RevWeaver/CamCap/housing/body.stl

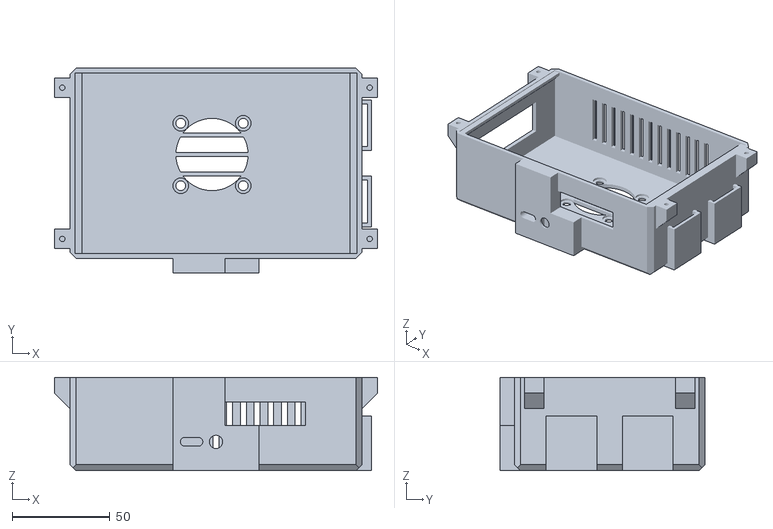
[picture p1: CAD file, 2026-10-09]
housing/body.stl
165.4 x 104.8 x 47.7
