RevWeaver/CamCap/housing/fan_mount_test.stl

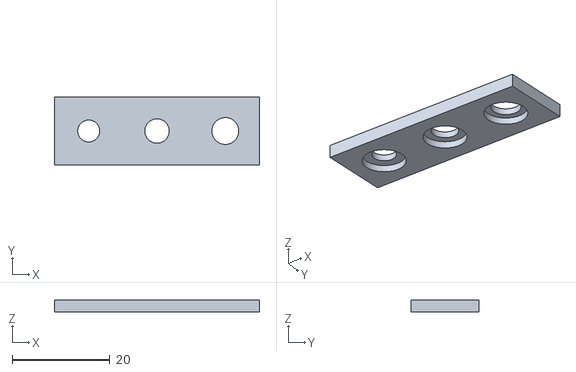
[picture p2: CAD file, 2026-10-09]
housing/fan_mount_test.stl
42.0 x 14.0 x 2.50
