RevWeaver/CamCap/housing/bezel.stl

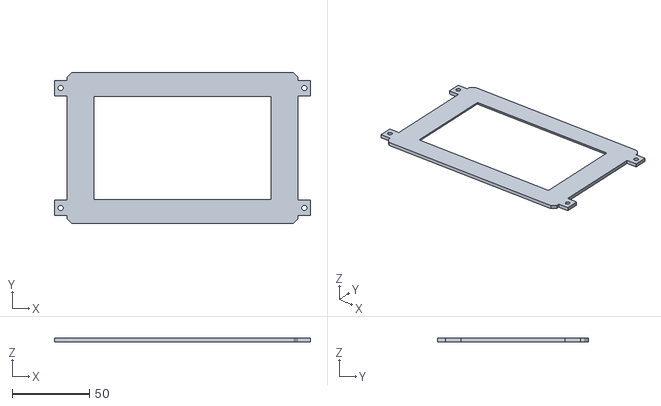
[picture p3: CAD file, 2026-10-09]
housing/bezel.stl
165.4 x 97.5 x 2.50
