RevWeaver/CamCap/(commit log)

2026-07-22 Add clean camera status display
2026-07-22 Expand camera configuration settings
2026-09-15 Replace storage.py with DriveManager, fix recording reliability bugs
    Rewrites the fixed-CAMCAP-label storage module as DriveManager, which
    detects and mounts arbitrary USB drives, sets up the CamCap directory
    layout, and checks writability against the actual mount state instead
    of just probing a path that can silently exist on the SD card after
    the SSD disconnects.
    Also fixes several bugs found while testing against the real camera
    and SSD:
    - storage_is_writable() reported writable even when the SSD wasn't
    mounted, because it only tried writing a file rather than checking
    is_mounted() first
    - Recorder.start() blocked all future recordings after any failed or
    dead ffmpeg process, since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
2026-09-15 Survive and recover from USB drive disconnect/reconnect
    Tested against a real unplug/replug of the recording SSD mid-session.
    Found and fixed two real bugs plus added the recovery path that was
    still missing:
    - Recorder.stop() crashed the whole app with an uncaught OSError when
    os.rename() failed because storage disappeared mid-write. A storage
    loss during stop now just gets logged instead of taking the process
    down.
    - DriveManager.mount_drive() trusted os.path.ismount() alone, but
    Linux doesn't clear the mount table when a drive is physically
    yanked - the mountpoint kept reporting "mounted" against a dead
    entry, so a reconnected drive was never remounted. mount_drive() now
    ch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
2026-09-16 Verify drive is actually writable before reporting mount success
    mount_drive() previously reported success whenever the mount command
    succeeded, even if the app couldn't write to the drive afterward -
    freshly formatted or foreign drives default to root ownership, unlike
    an SD card that just works. Now it verifies writability, auto-fixes
    ownership once if needed, and fails cleanly (unmount + False) if the
    drive still isn't usable.
    initialize() also now catches OSError and fails gracefully instead of
    crashing camcap.py's startup and storage watchdog when a drive can't
    be prepared.
2026-09-16 Add live preview, touch record controls, and recording review/playback
    Builds out ui/main_window.py into a real touchscreen GUI (PyQt5 on
    eglfs, no X11) with three screens: live camera preview + record/stop,
    a list of past recordings, and in-app playback with seek/pause. The
    "one reader at a time" camera handoff (preview <-> recorder) from the
    prior session's investigation is now actually implemented.
    Two reliability bugs found via hardware testing along the way:
    - Recorder.stop()'s multi-second ffmpeg shutdown drain was blocking
    the GUI thread, freezing the touch UI on every STOP press. Moved to
    a background StopWorker thread.
    - PreviewWorker/PlaybackWorker stopped draining ffmpeg's ou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
2026-09-17 Keep ffmpeg.log off the removable drive
    The log was written under CamCap/LOGS on the mounted SSD, so a drive
    disconnect wiped out the exact log you'd want to diagnose that
    disconnect. It now lives locally under CamCap/logs/, next to the app
    code, independent of whatever storage is plugged in.
    Verified with a real recording: log now lands at
    /home/deposit150/CamCap/logs/ffmpeg.log and the drive's LOGS folder is
    no longer touched.
2026-09-17 Fix real thermal throttling during sustained recording with x264 preset
    Hardware-tested a 3-minute sustained 1080p30 recording on the Pi 4B:
    the default libx264 preset ("medium") pushed the Pi into real thermal
    throttling within ~90s (measured up to 85C, throttled=0xe0008), and
    once throttled, ffmpeg's shutdown drain exceeded STOP_TIMEOUT_SECONDS
    and had to be SIGKILLed - which left the recording renamed into the
    final filename without ever getting a matroska trailer, so it reports
    no duration despite the video data itself still being decodable.
    Switching to "-preset veryfast" was tested the same way (same 3-minute
    recording, same starting temp): held steady at 62-70C with no
    throttling at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
2026-09-17 Fix camera detection to actually use the stable by-id device path
    config.CAMERA_DEVICE already held the persistent
    /dev/v4l/by-id/...-video-index0 path from an earlier fix, but nothing
    in the codebase ever read it - both ui/main_window.py and the old
    camcap.py terminal loop call camera.get_camera_device() instead, which
    parsed `v4l2-ctl --list-devices` and returned whatever /dev/videoN
    index the kernel happened to enumerate that boot. That index isn't
    guaranteed stable across reboots or USB resets (the Pi's own bcm2835
    codec nodes and the Cam Link both show up as /dev/videoN), so the
    by-id fix was silently dead code.
    get_camera_device() now resolves the by-id symlink directly and is the
    sin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
2026-09-17 Detect camera disconnect/reconnect while idle, mirroring the storage watchdog
    Storage already has a watchdog that notices a lost/reconnected drive
    and recovers automatically, but nothing did the equivalent for the
    camera - if the Cam Link disconnected while idle or previewing (or hit
    the known UVC URB wedge), the app just froze on the last preview frame
    forever with the status bar still claiming "Cam: OK", and never
    recovered even if the camera came back.
    _watchdog_tick now also polls camera.get_camera_device() each tick:
    on disconnect, stops the preview cleanly and shows "No camera
    detected"; on reconnect, restarts the preview automatically. A
    recording in progress is already handled by th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
2026-09-17 Finalize an active recording on graceful shutdown (SIGTERM/SIGINT)
    main.py had no signal handler, so `systemctl stop camcap`,
    `sudo poweroff`, and `sudo reboot` killed the process outright without
    ever running closeEvent - ffmpeg itself shuts down cleanly on the same
    SIGTERM (from the shared cgroup kill), but the .tmp -> final rename only
    happens in Python, so an in-progress recording was stranded as an
    unfinalized .tmp file forever. Also found the previously-untested idle
    shutdown path was exiting status=1/FAILURE.
    Added a SIGTERM/SIGINT handler (via a QTimer poll, since a Qt app
    blocked in its C++ event loop won't otherwise notice a Python signal in
    time) that triggers window.close(), reu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
2026-09-25 Restart a dead preview when the camera is present
    A fast Cam Link unplug/replug can fall entirely between two watchdog
    ticks, so the disconnect branch never fires - but ffmpeg still exits
    when the device vanishes, leaving a frozen preview while the app thinks
    the camera is fine. Restart the preview whenever its worker has
    finished, rate-limited to once per 5s to avoid hammering the UVC driver.
2026-09-25 Switch recording to the Pi's hardware H.264 encoder
    libx264 can't encode real 1080p30 camera footage in real time on the
    Pi 4: on a detailed scene veryfast managed ~11fps and ultrafast ~24fps
    with all cores pegged. Recordings dropped most frames and wrote nothing
    within the 2s health-check window, so every recording was killed and
    discarded after ~5s.
    h264_v4l2m2m held ~29fps over a 3-minute test with no kernel errors
    (including repeated start/stop cycles), stops cleanly in ~1-3s, and
    writes data well within the health-check window. Set a 2s keyframe
    interval; the encoder's default of 12 frames wastes bitrate.
2026-09-25 Warn on the status bar when the Cam Link is on a USB 2 port
    Uncompressed 1080p30 doesn't fit through USB 2: the preview still limps
    along, but recordings get corrupted/empty frames and fail after the
    health check. Hardware-tested through a USB 2.0 hub. Read the link speed
    from sysfs and show 'SLOW USB PORT' instead of 'OK'.
2026-09-25 Add touchscreen boot fix and track system config files
    - camcap-touch.service re-binds the Goodix touch controller at boot; it
    fails its probe because it's probed before the DSI panel powers up.
    camcap.service now Wants/After it (not Requires, so the app still runs
    if touch fails).
    - Track eglfs_kms.json (pins Qt to the DSI panel, HDMI off) and copies of
    camcap.service and the touch-rotation udev rule under system/, so a
    fresh Pi can be rebuilt from git. README documents where each goes.
2026-09-30 Show the Pi's CPU temperature in the status bar
2026-09-30 Colour the status bar temperature orange at 70C and red at 80C
2026-10-09 Add 3D-printed housing (v0.5.2) with rendered STLs
    OpenSCAD source for the upright field-monitor case plus the body, bezel
    and fan mount test STLs, rendered from it.
    Changes since the first printed version (v0.2):
    - Bottom plate with a captive 1/4"-20 nut (crush ribs hold it in) and an
    anti-twist pin slot, for a ball-head shoe mount; replaces the printed
    cold-shoe foot
    - Power slot 1" longer to the right; the plate corner that would print
    hanging over it is trimmed away
    - Display stops 1mm wider on each side
    - 3mm chamfers on the body's long edges and around the fan wall (left
    square behind the strap loops), with matching bezel corners; screw
    tabs moved 2mm in so each chamfer meet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
2026-10-11 Record audio from the DJI Mic Mini receiver when it's plugged in
    The receiver shows up as a USB ALSA card that only offers 48kHz stereo
    S24_3LE, so ffmpeg's ALSA input needs pcm_s24le given explicitly.
    microphone.py finds it via /dev/snd/by-id (card numbers aren't stable)
    and the recorder adds it as an optional AAC track - no receiver means a
    video-only recording, not a failure. If the receiver drops out
    mid-recording ffmpeg keeps recording video (hardware-tested by
    deauthorizing it over USB); the status bar shows Mic: OK / NONE / LOST.
    A/V start offset measured on a common clock: audio's first sample lands
    ~20ms after video's first frame, consistently over 6 runs - under one
    frame, so ffmp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
2026-10-12 Add an on-screen power menu for shutting down or restarting
    A power-icon button at the far left of the control bar opens a page
    with SHUT DOWN / RESTART / CANCEL, so the appliance can be turned off
    without pulling power on a running Pi. It runs `sudo systemctl
    poweroff|reboot`; systemd's SIGTERM then goes through main.py's
    existing clean-close path. Disabled while recording.
2026-10-12 Tell the user to restart when the hardware encoder has crashed
    After the bcm2835_codec Oops every encoder open hangs until a reboot,
    so recordings just silently failed to start. The app now checks this
    boot's kernel log for the crash at startup and whenever a recording
    fails to start or dies. If it finds it, RECORD becomes RESTART NEEDED
    (tapping it opens the power menu with an explanation) and the status
    bar shows ENCODER CRASHED. The no-data retry is skipped in that case
    since it would only hang again.
    The status bar now wraps between items so the wider button still fits
    on the 1280px screen.
